dinitrogen/MIDI-bit-box/enclosure-artwork/tayda-print-files/bit-box-turbo-v1.0.pdf

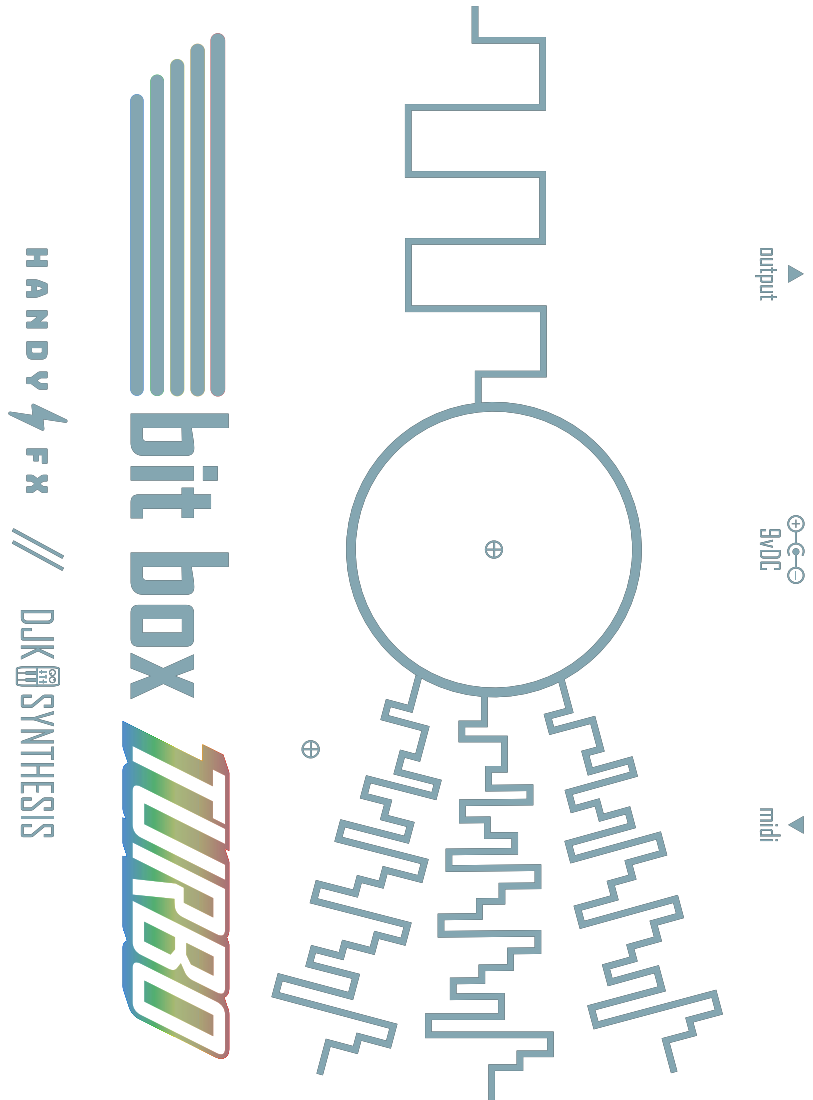
[picture p1: page 1]
