dinitrogen/MIDI-bit-box/enclosure-artwork/bit-box-turbo-v1.0.pdf

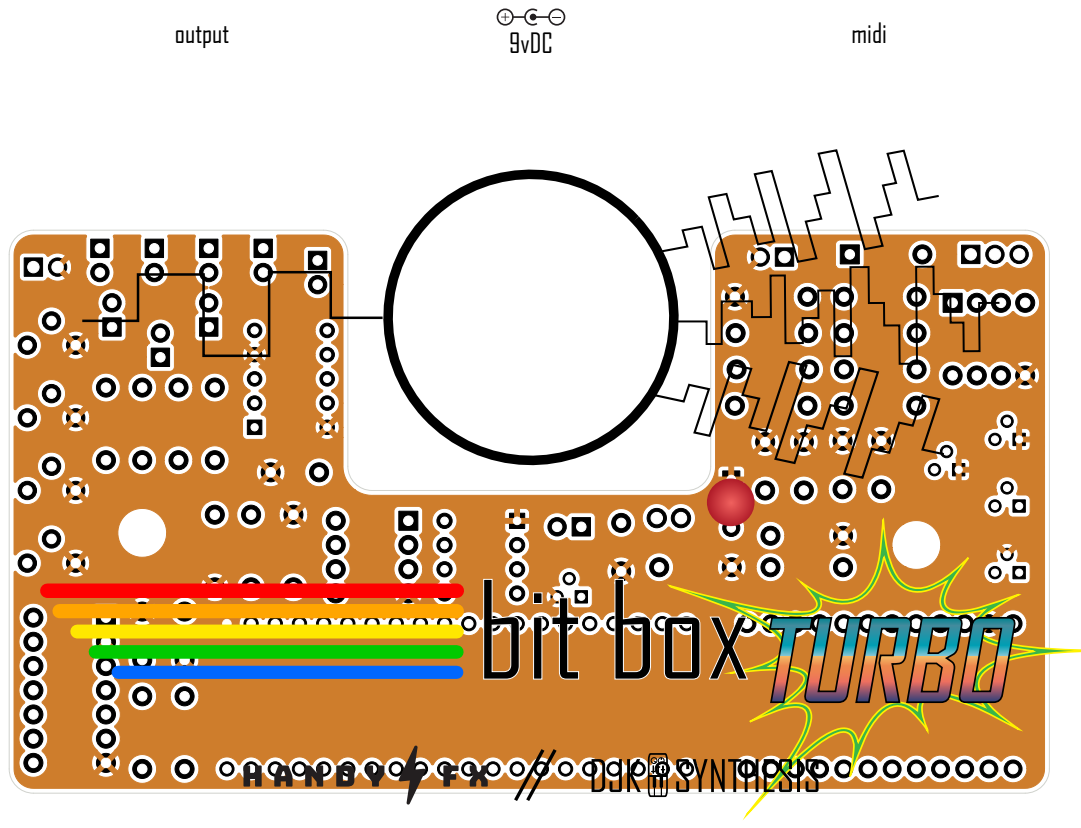
[picture p2: page 1]
bit box; 9vDC output; midi
