dinitrogen/MIDI-bit-box/enclosure-artwork/bit-box-turbo-v1.0_hidden_pcb.pdf

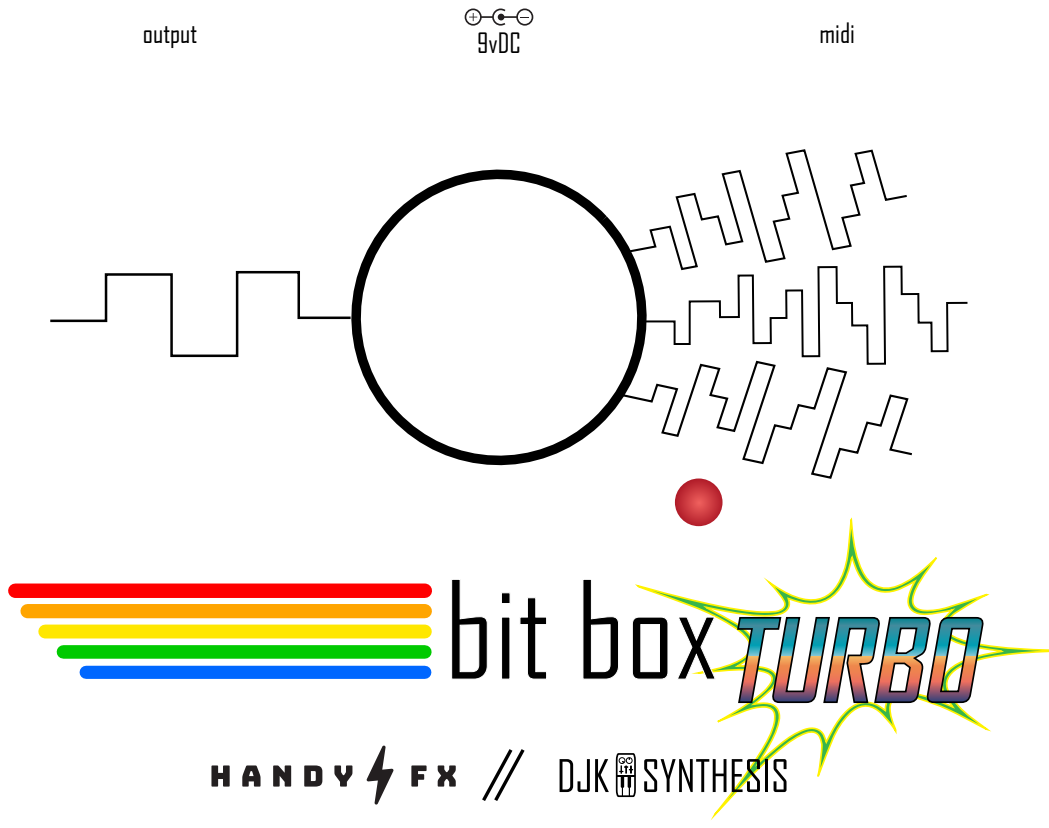
[picture p3: page 1]
bit box; 9vDC output; midi
