dinitrogen/MIDI-bit-box/kicad/midi-bit-box-v1.kicad_pcb

## KiCad design kicad/midi-bit-box-v1.kicad_pcb (2022-02-08)

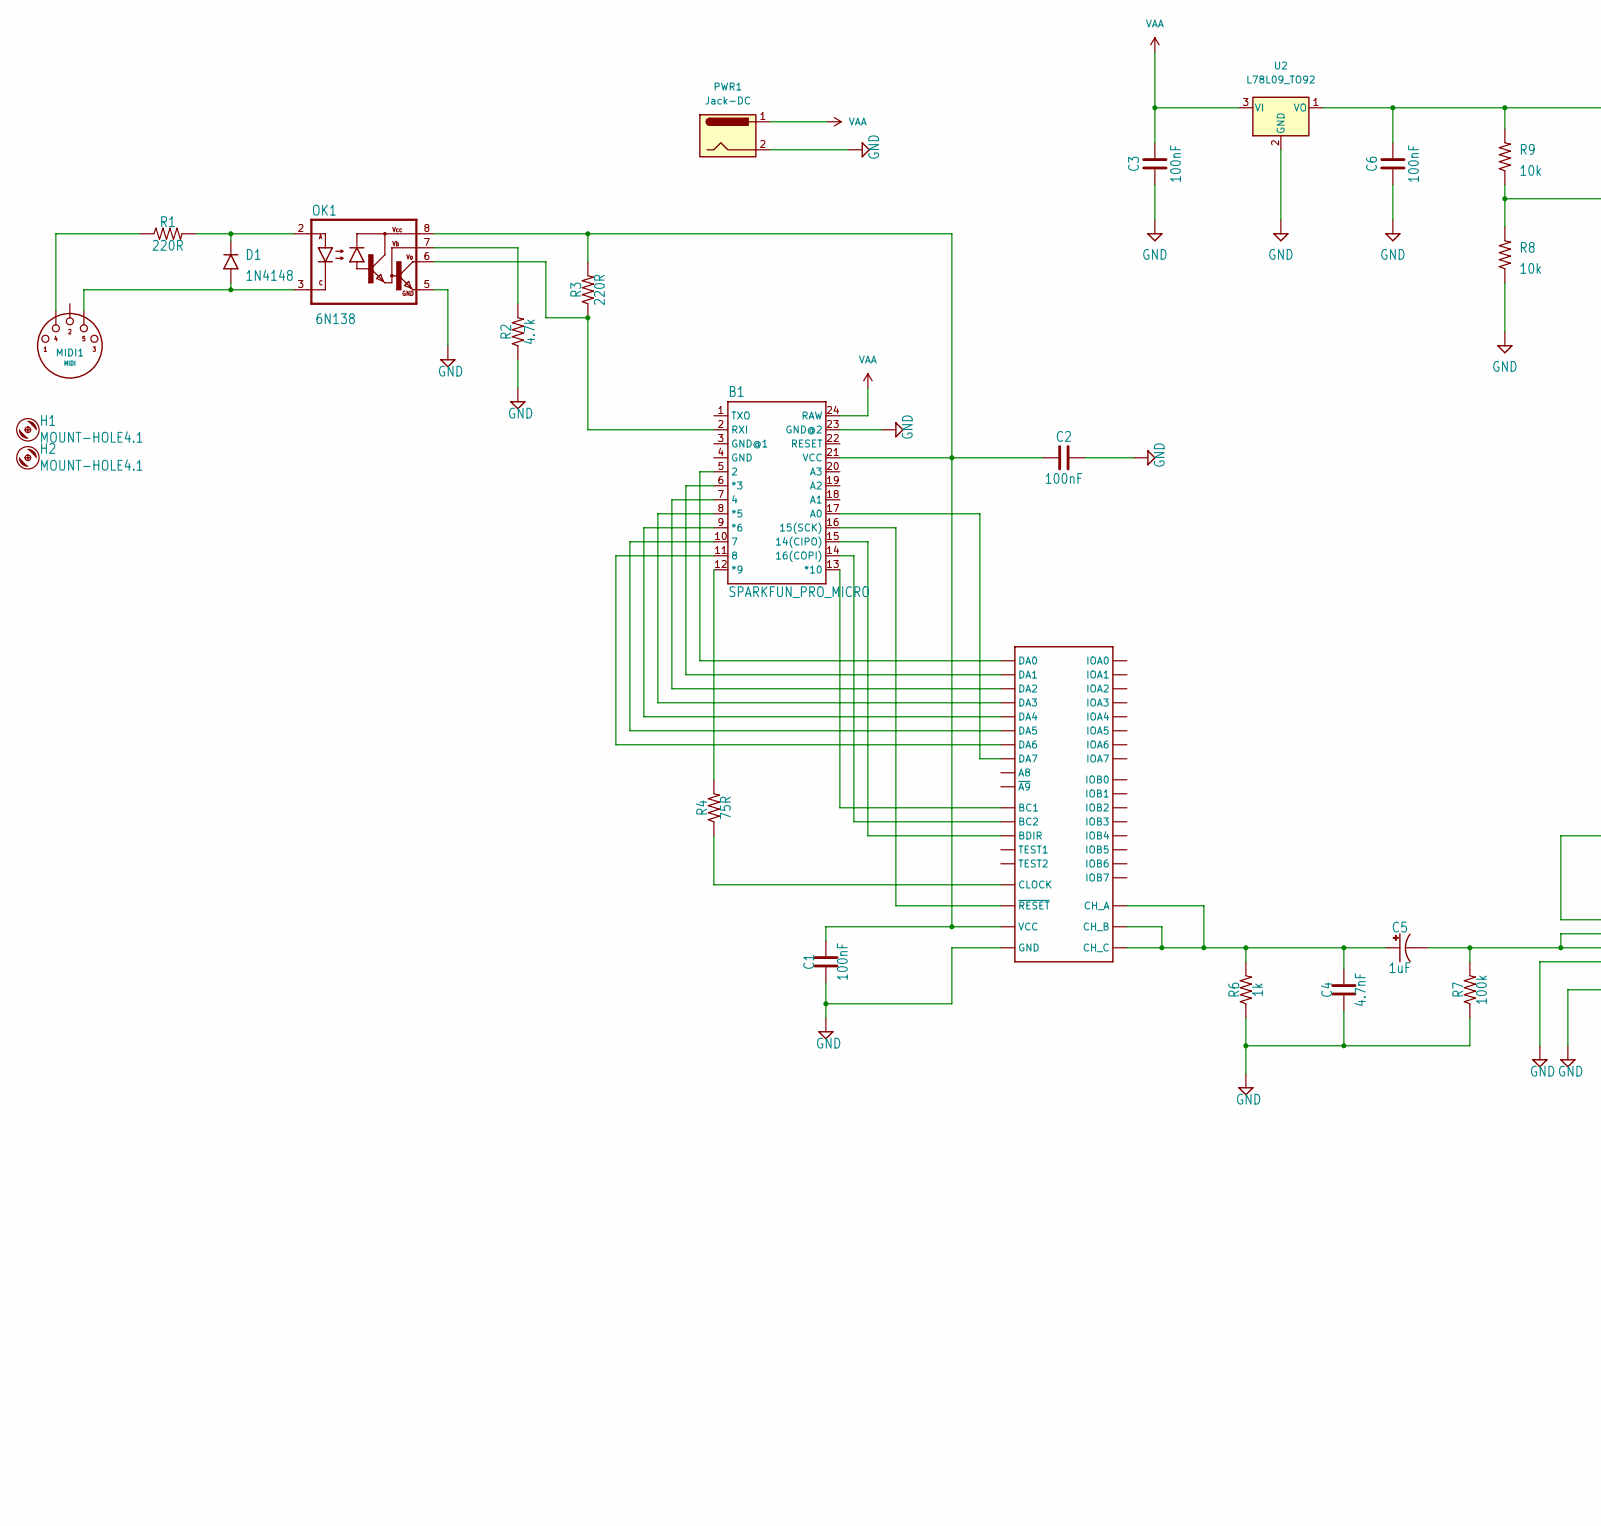
[picture p4: schematic midi-bit-box-v1.kicad_sch, part in row 1, column 1]

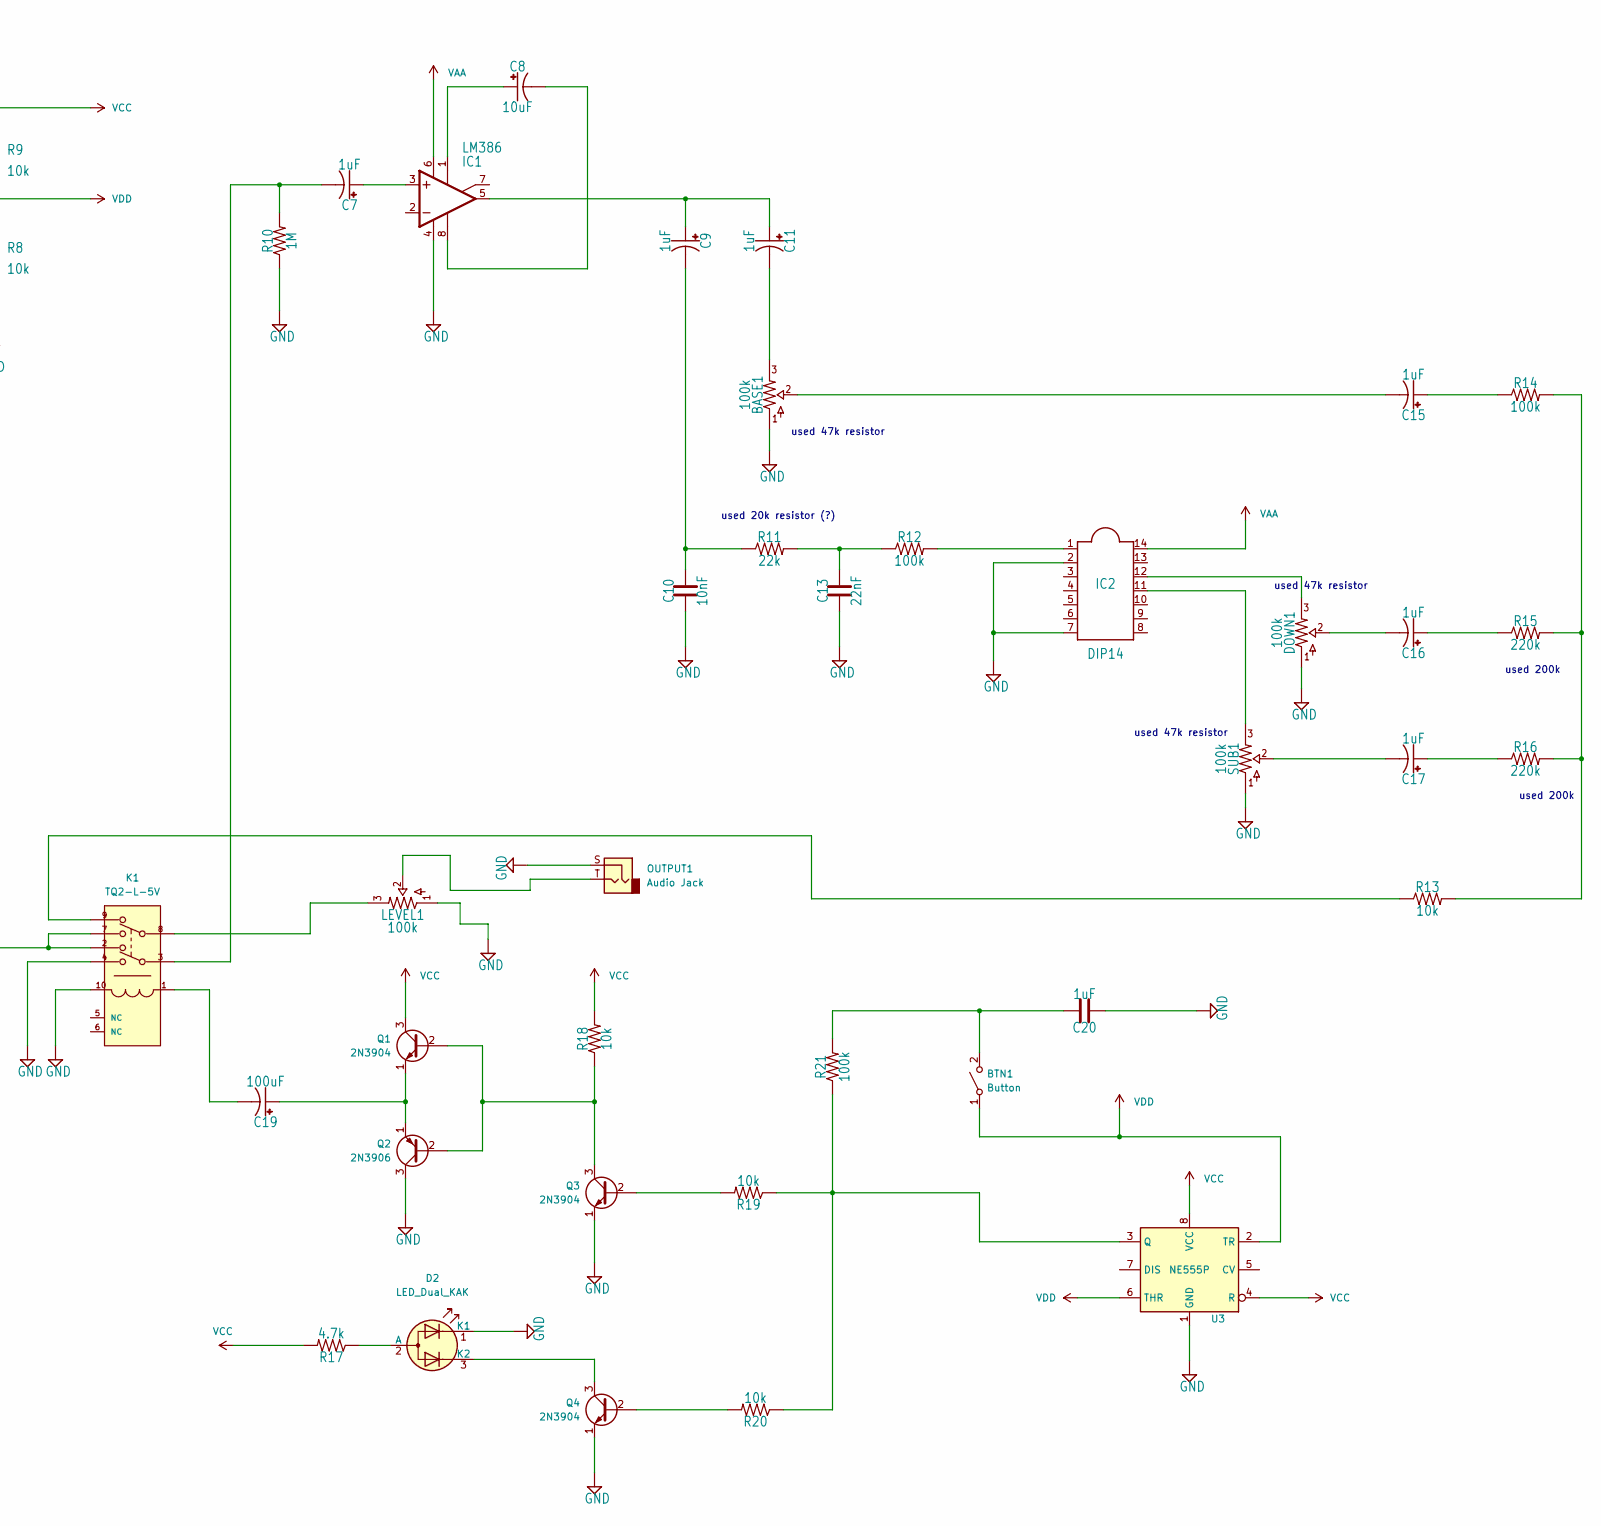
[picture p5: schematic midi-bit-box-v1.kicad_sch, part in row 1, column 2]

Parts:
B1: SPARKFUN_PRO_MICRO
BASE1: 100k; TRIM1
BTN1: Button; ARCADE_BUTTON
C1, C2, C3, C6: 100nF; 0.2_.SML
C4: 4.7nF; 0.2_.SML
C5, C7, C9, C11, C15, C16, C17: 1uF; 0502
C8: 10uF; 0502
C10: 10nF; 0.2_.SML
C13: 22nF; 0.2_.SML
C19: 100uF; 0502
C20: 1uF; 0.2_.SML
D1: 1N4148; DO41-3
D2: LED_Dual_KAK; LED_D5.0mm-3
DOWN1: 100k; TRIM1
H1, H2: MOUNT-HOLE4.1; 4,1
IC1: LM386; DIP08
IC2: DIP14; DIP14.1
K1: TQ2-L-5V; Panasonic-TQ2-L-5V-MFG; coil voltage 5V; current rating 1A; mouser part number 769-TQ2-L-5V; digikey description RELAY TELECOM DPDT 1A 5VDC
LEVEL1: 100k; TRIM1
MIDI1: MIDI; 3PADS
OK1: 6N138; DIP08
OUTPUT1: Audio Jack; 2PADS
PWR1: Jack-DC; DC_TS
Q1, Q3, Q4: 2N3904; TO-92-djk-custom
Q2: 2N3906; TO-92-djk-custom
R1, R3: 220R; 0.3_.B
R2, R17: 4.7k; 0.3_.B
R4: 75R; 0.3_.B
R6: 1k; 0.3_.B
R7, R12, R14, R21: 100k; 0.3_.B
R8, R9, R13, R18, R19, R20: 10k; 0.3_.B
R10: 1M; 0.3_.B
R11: 22k; 0.3_.B
R15, R16: 220k; 0.3_.B
SUB1: 100k; TRIM1
U1: AY-3-8910; DIP-40_600MIL
U2: L78L09_TO92; TO-92-djk-custom
U3: NE555P; DIP-8_W7.62mm

Connections:
GND: B1.23 (GND@2), BASE1.1, C1.2, C2.2, C3.1, C4.1, C6.1, C10.1, C13.1, C20.1, D2.1 (K1), DOWN1.1, IC1.4 (V-), IC2.2, IC2.7, K1.4, K1.10 (S-/R+), LEVEL1.1, OK1.5 (GND), OUTPUT1.S, PWR1.2, Q2.3 (C), Q3.1 (E), Q4.1 (E), R2.1, R6.1, R7.1, R8.1, R10.1, SUB1.1, U1.1 (GND), U2.2 (GND), U3.1 (GND)
unnamed: B1.2 (RXI), OK1.6 (VO), R3.1
unnamed: B1.5 (2), U1.37 (DA0)
unnamed: B1.6 (*3), U1.36 (DA1)
unnamed: B1.7 (4), U1.35 (DA2)
unnamed: B1.8 (*5), U1.34 (DA3)
unnamed: B1.9 (*6), U1.33 (DA4)
unnamed: B1.10 (7), U1.32 (DA5)
unnamed: B1.11 (8), U1.31 (DA6)
unnamed: B1.12 (*9), R4.2
unnamed: B1.13 (*10), U1.29 (BC1)
unnamed: B1.14 (16(COPI)), U1.28 (BC2)
unnamed: B1.15 (14(CIPO)), U1.27 (BDIR)
unnamed: B1.16 (15(SCK)), U1.23 (~RESET)
unnamed: B1.17 (A0), U1.30 (DA7)
unnamed: B1.21 (VCC), C1.1, C2.1, OK1.8 (VCC), R3.2, U1.40 (VCC)
unnamed: BASE1.2, C15.-
unnamed: BASE1.3, C11.-
unnamed: BTN1.2 (B), C20.2, R21.2
unnamed: C4.2, C5.+, R6.2, U1.3 (CH_B), U1.4 (CH_A), U1.38 (CH_C)
unnamed: C5.-, K1.2, K1.7, R7.2
unnamed: C7.+, IC1.3 (+IN)
unnamed: C7.-, K1.3, R10.2
unnamed: C8.+, IC1.1 (GAIN1)
unnamed: C8.-, IC1.8 (GAIN2)
unnamed: C9.-, C10.2, R11.1
unnamed: C9.+, C11.+, IC1.5 (OUT)
unnamed: C13.2, R11.2, R12.1
unnamed: C15.+, R14.1
unnamed: C16.+, R15.1
unnamed: C16.-, DOWN1.2
unnamed: C17.+, R16.1
unnamed: C17.-, SUB1.2
unnamed: C19.+, Q1.1 (E), Q2.1 (E)
unnamed: C19.-, K1.1 (S+/R-)
unnamed: D1.A, MIDI1.S (5), OK1.3 (C)
unnamed: D1.C, OK1.2 (A), R1.2
unnamed: D2.2 (A), R17.1
unnamed: D2.3 (K2), Q4.3 (C)
unnamed: DOWN1.3, IC2.12
unnamed: IC2.1, R12.2
unnamed: IC2.11, SUB1.3
unnamed: K1.8, LEVEL1.3
unnamed: K1.9, R13.1
unnamed: LEVEL1.2, OUTPUT1.T
unnamed: MIDI1.T (4), R1.1
unnamed: OK1.7 (VB), R2.2
unnamed: Q1.2 (B), Q2.2 (B), Q3.3 (C), R18.1
unnamed: Q3.2 (B), R19.2
unnamed: Q4.2 (B), R20.2
unnamed: R4.1, U1.22 (CLOCK)
unnamed: R13.2, R14.2, R15.2, R16.2
unnamed: R19.1, R20.1, R21.1, U3.3 (Q)
VAA: B1.24 (RAW), C3.2, IC1.6 (V+), IC2.14, PWR1.1, U2.3 (VI)
VCC: C6.2, Q1.3 (C), R9.2, R17.2, R18.2, U2.1 (VO), U3.4 (R), U3.8 (VCC)
VDD: BTN1.1 (A), R8.2, R9.1, U3.2 (TR), U3.6 (THR)

Notes on the sheet:
used 20k resistor (?)
used 200k
used 200k
used 47k resistor

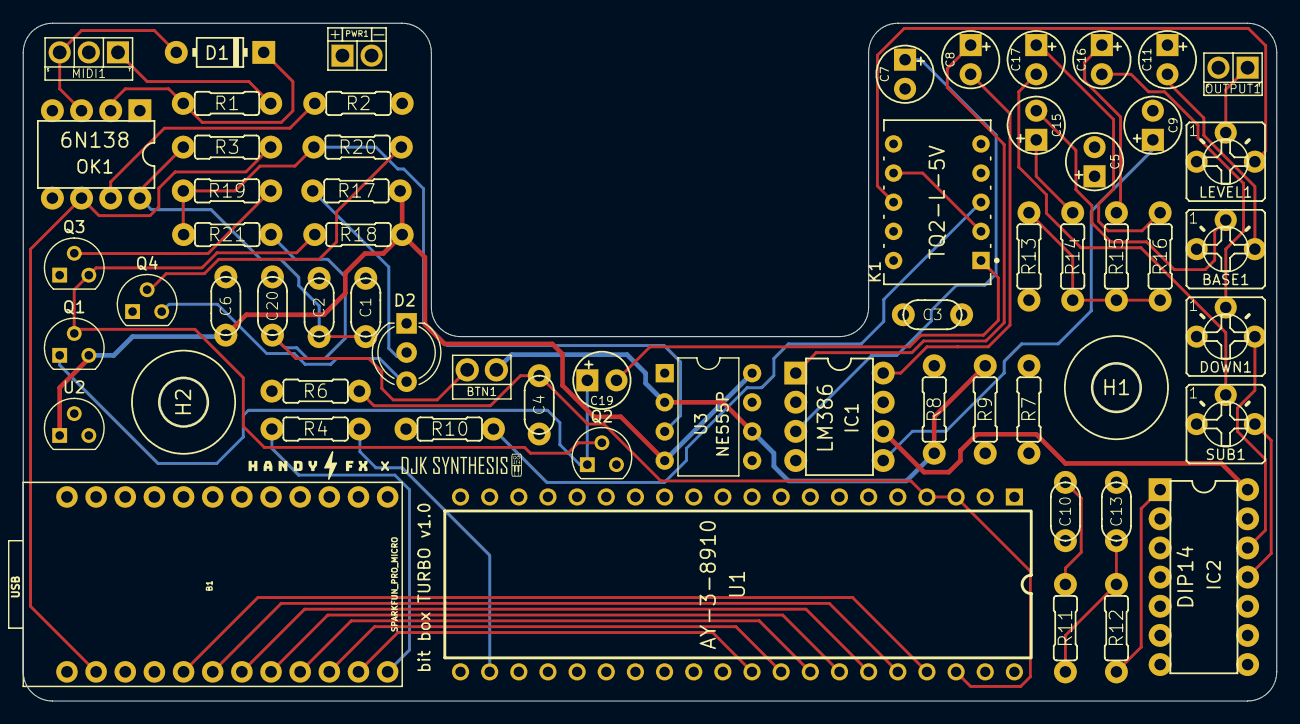
[picture p6: board midi-bit-box-v1.kicad_pcb from above]

Board: 4 copper layers, 109.2 x 59.1 mm, 61 parts (0 on the bottom side), 56 nets.
