dinitrogen/MIDI-bit-box/midi-bit-box-v1.brd

## EAGLE design midi-bit-box-v1.brd (2022-01-26)

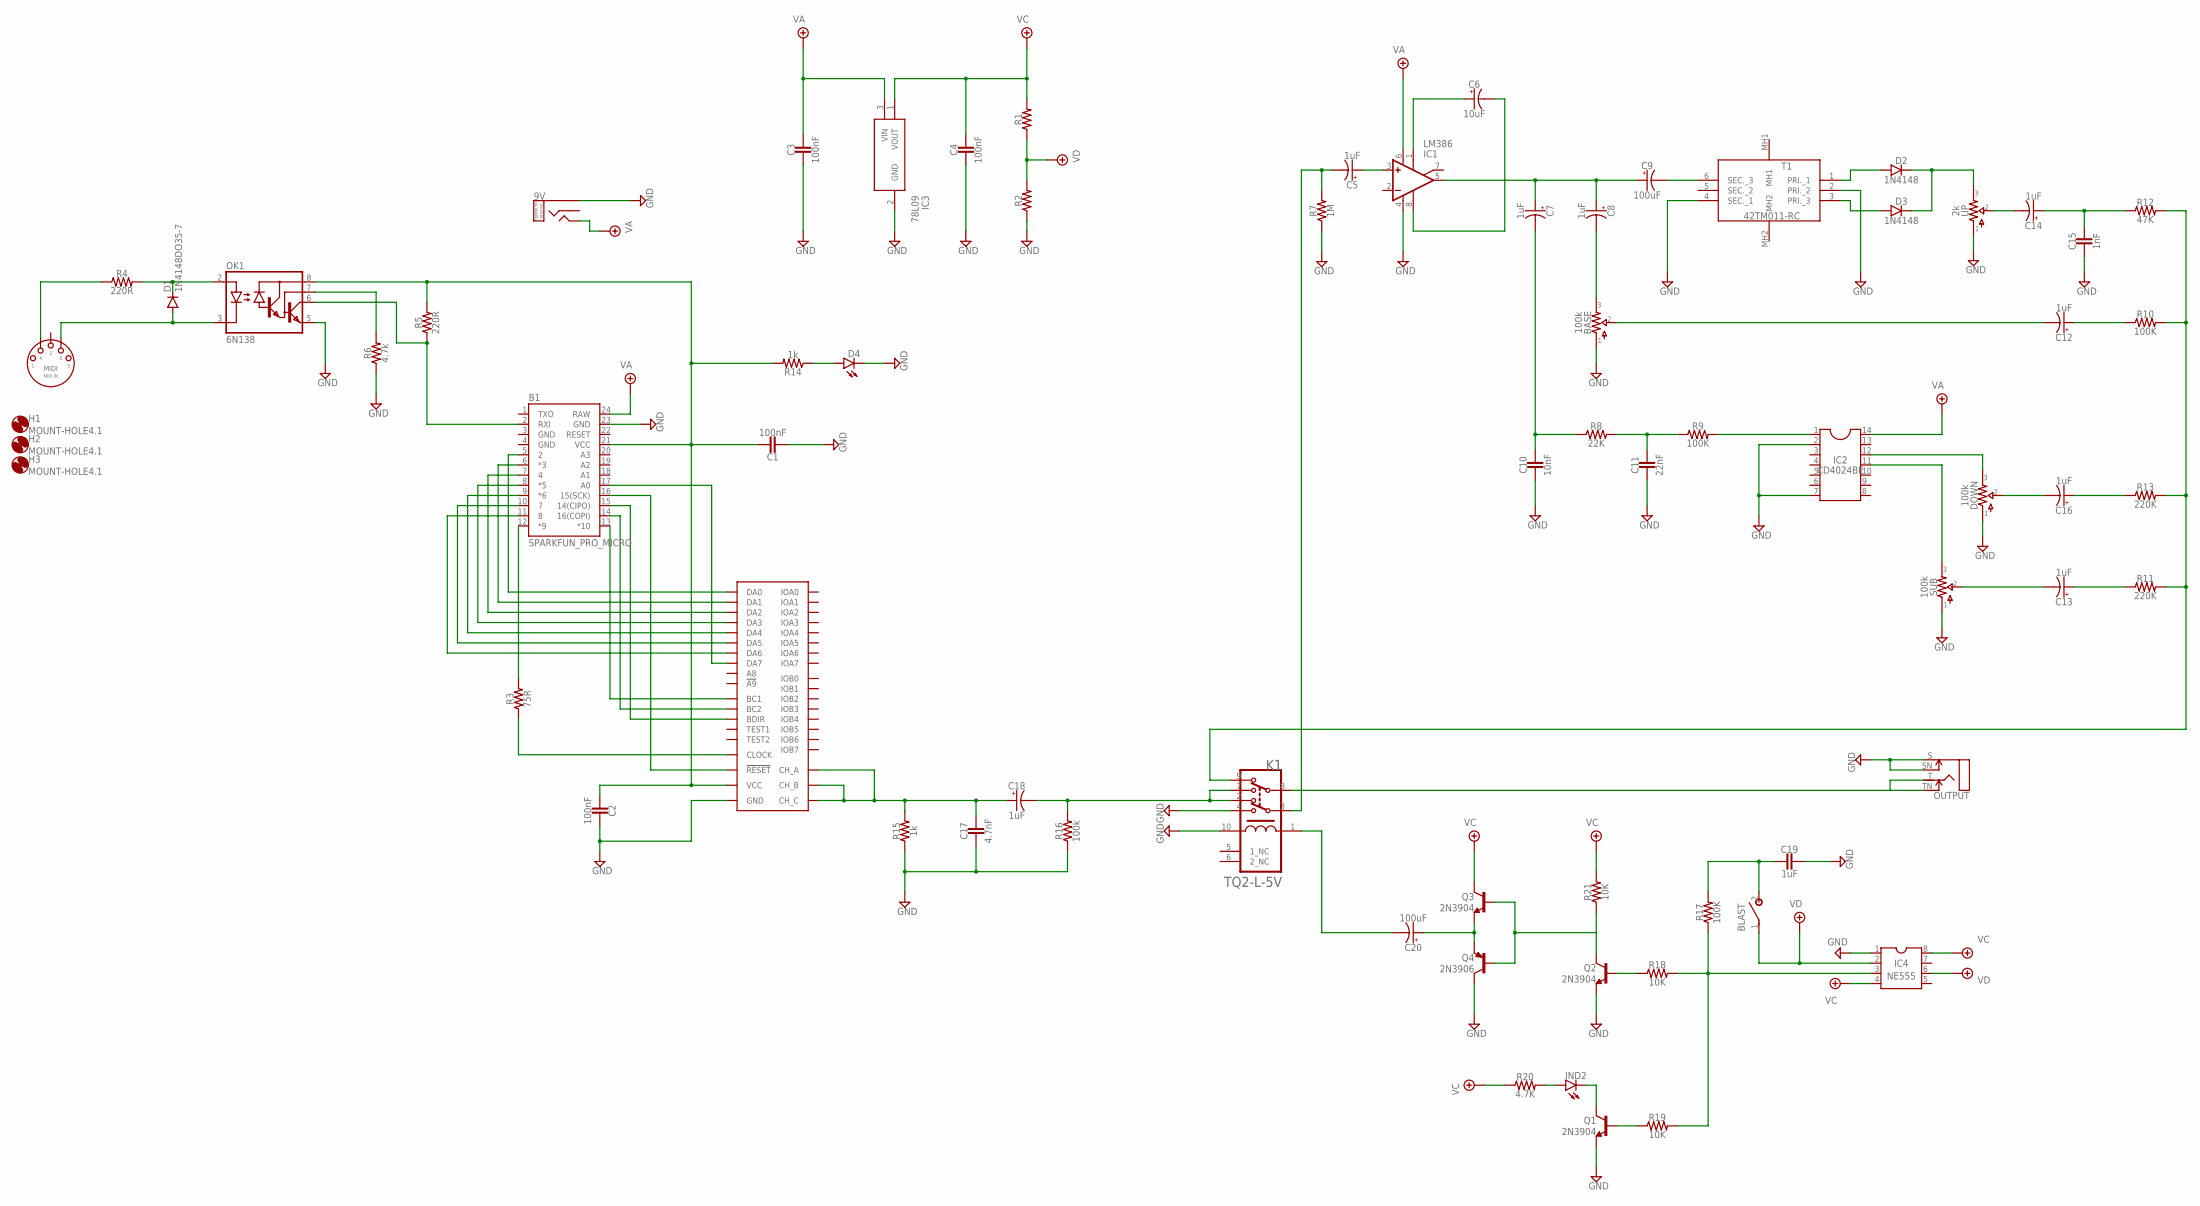
[picture p7: schematic midi-bit-box-v1.sch]

Parts:
9V: DC_TRS_PADS; DC_TRS
B1: SPARKFUN_PRO_MICRO
BASE: 100k; TRIM1
BLAST: SPST; SPST.WIRE
C1, C2, C3, C4: 100nF; 0.2".SML
C5, C7, C8, C12, C13, C14, C16, C18: 1uF; 0502
C6: 10uF; 0502
C9, C20: 100uF; 0502
C10: 10nF; 0.2".SML
C11: 22nF; 0.2".SML
C15: 1nF; 0.2".SML
C17: 4.7nF; 0.2".SML
C19: 1uF; 0.2".LRG
D1: 1N4148DO35-7; DO35-7
D2, D3: 1N4148; DO41-3
D4: LED.2; 3MM_1
DOWN: 100k; TRIM1
H1, H2, H3: MOUNT-HOLE4.1; 4,1
IC1: LM386; DIP08
IC2: CD4024BE; DIP14.1
IC3: 78L09; L78L09ACZTR
IC4: NE555; DIP08
IND2: 5MM_LED; 3MM_1
K1: PANASONIC_TQ2-L-5VPANASONIC_TQ2-L-5V_0_0; PANASONIC_TQ2-L-5V_0
MIDI: MIDI IN; 3PADS
OK1: 6N138; DIL08
OUTPUT: SWITCHED_MONO_PADS; 4PADS
Q1, Q2, Q3: 2N3904; TO92
Q4: 2N3906; TO92
R1, R2: R.3B; 0.3".B
R3: 75R; 0.3".B
R4, R5: 220R; 0.3".B
R6: 4.7k; 0.3".B
R7: 1M; 0.3".B
R8: 22K; 0.3".B
R9, R10, R17: 100K; 0.3".B
R11, R13: 220K; 0.3".B
R12: 47K; 0.3".B
R14, R15: 1k; 0.3".B
R16: 100k; 0.3".B
R18, R19, R21: 10K; 0.3".B
R20: 4.7K; 0.3".B
SUB: 100k; TRIM1
T1: 42TM011-RC; 42TM011RC
U1: AY-3-8910; DIP-40/600MIL
UP: 2k; TRIM1

Connections:
GND: 9V.PWR, B1.3 (GND), B1.4 (GND), B1.23 (GND), BASE.1, C1.2, C2.1, C3.2, C4.2, C10.2, C11.2, C15.2, C17.2, C19.1, D4.K (C), DOWN.1, IC1.4 (V-), IC2.2, IC2.7, IC3.2 (GND), IC4.1, K1.4, K1.10 (S-/R+), OK1.5 (GND), OUTPUT.S, OUTPUT.SN, Q1.3 (E), Q2.3 (E), Q4.1 (C), R2.1, R6.1, R7.1, R15.1, R16.1, SUB.1, T1.2 (PRI._2), T1.4 (SEC._1), U1.1 (GND), UP.1
unnamed: MIDI.T (4), R4.1
unnamed: D1.C, OK1.2 (A), R4.2
unnamed: D1.A, MIDI.S (5), OK1.3 (C)
unnamed: B1.21 (VCC), C1.1, C2.2, OK1.8 (VCC), R5.2, R14.2, U1.40 (VCC)
unnamed: OK1.7 (VB), R6.2
unnamed: B1.2 (RXI), OK1.6 (VO), R5.1
unnamed: IC4.3, R17.1, R18.2, R19.2
unnamed: K1.8, OUTPUT.T, OUTPUT.TN
unnamed: B1.12 (*9), R3.2
unnamed: R3.1, U1.22 (CLOCK)
unnamed: B1.16 (15(SCK)), U1.23 (!RESET)
unnamed: B1.5 (2), U1.37 (DA0)
unnamed: B1.6 (*3), U1.36 (DA1)
unnamed: B1.7 (4), U1.35 (DA2)
unnamed: B1.8 (*5), U1.34 (DA3)
unnamed: B1.9 (*6), U1.33 (DA4)
unnamed: B1.10 (7), U1.32 (DA5)
unnamed: B1.11 (8), U1.31 (DA6)
unnamed: B1.17 (A0), U1.30 (DA7)
unnamed: B1.13 (*10), U1.29 (BC1)
unnamed: B1.14 (16(COPI)), U1.28 (BC2)
unnamed: B1.15 (14(CIPO)), U1.27 (BDIR)
unnamed: BASE.2, C12.-
unnamed: C16.-, DOWN.2
unnamed: DOWN.3, IC2.12
unnamed: C5.+, IC1.3 (+IN)
unnamed: C6.+, IC1.1 (GAIN1)
unnamed: C6.-, IC1.8 (GAIN2)
unnamed: C7.+, C8.+, C9.+, IC1.5 (OUT)
unnamed: C9.-, T1.6 (SEC._3)
unnamed: D2.A, T1.1 (PRI._1)
unnamed: D3.A, T1.3 (PRI._3)
unnamed: BASE.3, C8.-
unnamed: C7.-, C10.1, R8.1
unnamed: C11.1, R8.2, R9.1
unnamed: IC2.11, SUB.3
unnamed: C13.-, SUB.2
unnamed: D4.A, R14.1
unnamed: C14.-, UP.2
unnamed: BLAST.2, C19.2, R17.2
unnamed: C12.+, R10.1
unnamed: C16.+, R13.1
unnamed: C13.+, R11.1
unnamed: D2.C, D3.C, UP.3
unnamed: C5.-, K1.3, R7.2
unnamed: C14.+, C15.1, R12.1
unnamed: C17.1, C18.+, R15.2, U1.3 (CH_B), U1.4 (CH_A), U1.38 (CH_C)
unnamed: IC2.1, R9.2
unnamed: IND2.A, R20.2
unnamed: Q2.1 (C), R21.1
unnamed: Q2.2 (B), R18.1
unnamed: Q1.2 (B), R19.1
unnamed: IND2.K (C), Q1.1 (C)
unnamed: C20.+, Q3.3 (E), Q4.3 (E)
unnamed: Q3.2 (B), Q4.2 (B)
unnamed: C20.-, K1.1 (S+/R-)
unnamed: C18.-, K1.2, K1.7, R16.2
unnamed: K1.9, R10.2, R11.2, R12.2, R13.2
VA: 9V.GND, B1.24 (RAW), C3.1, IC1.6 (V+), IC2.14, IC3.3 (VIN)
VC: C4.1, IC3.1 (VOUT), IC4.4, IC4.8, Q3.1 (C), R1.2, R20.1, R21.2
VD: BLAST.1, IC4.2, IC4.6, R1.1, R2.2

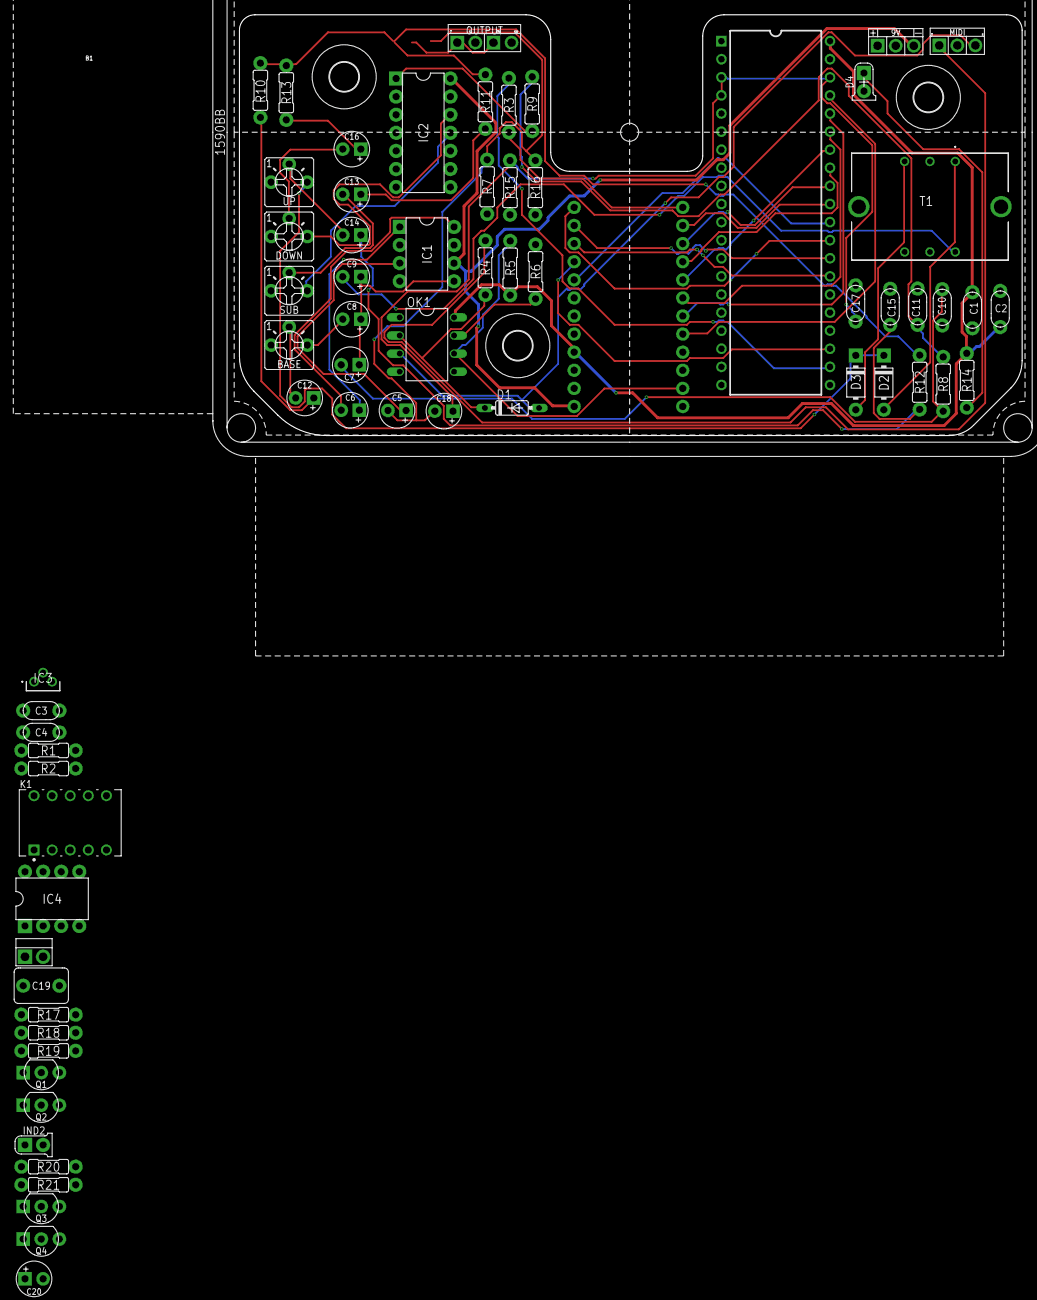
[picture p8: board midi-bit-box-v1.brd from above]

Board: 2 copper layers, 109.9 x 59.1 mm, 71 parts (1 on the bottom side), 62 nets.

Other parts of the board:
U$1: 1590BB
