dinitrogen/MIDI-bit-box/(commit log)

2022-01-26 Added SPST and latching relay switching circuit
    [midi-bit-box-v1.brd, midi-bit-box-v1.sch]
2022-02-03 Create kicad
2022-02-03 Add files via upload
    initial kicad uploads
    [midi-bit-box-v1.kicad_pcb, midi-bit-box-v1.kicad_sch]
2022-02-04 Add files via upload
    updated pwr/audio jacks and design rules
    [midi-bit-box-v1.kicad_pcb, midi-bit-box-v1.kicad_sch]
2022-02-05 added dual LED
    [midi-bit-box-v1.kicad_pcb, midi-bit-box-v1.kicad_sch]
2022-02-07 added trimpot to control output volume
    [midi-bit-box-v1.kicad_pcb, midi-bit-box-v1.kicad_sch]
2022-02-08 corrected DC input jack pads
    [midi-bit-box-v1.kicad_pcb, midi-bit-box-v1.kicad_sch]
2022-02-08 corrected DC input pad shapes
    [midi-bit-box-v1.kicad_pcb]
2022-02-23 enclosure graphic first draft
2022-02-24 updates to enclosure graphic
2022-02-27 draft print files
2022-05-01 Added gerbers
